hubosmart/hubo-backpack-template/(notices)

Notices in the files:
kicad/hubo-backpack-template.kicad_sch:
License: CERN-OHL-P-2.0
